Marcoss53/cenk-desktop-robot/3d-models/desk_robot_v1.3mf

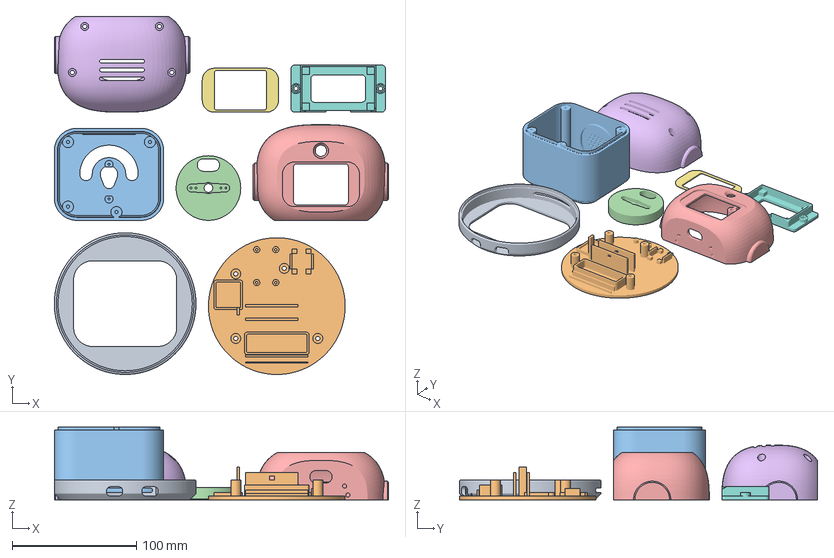
[picture p6: CAD file, 2026-10-13]
3d-models/desk_robot_v1.3mf
269.0 x 288.0 x 58.4 mm
pedestal
base_plate
body_shell
neck_hub
head_front
head_back
visor
display_bracket
