Marcoss53/cenk-desktop-robot/3d-models/stl/neck_hub.stl

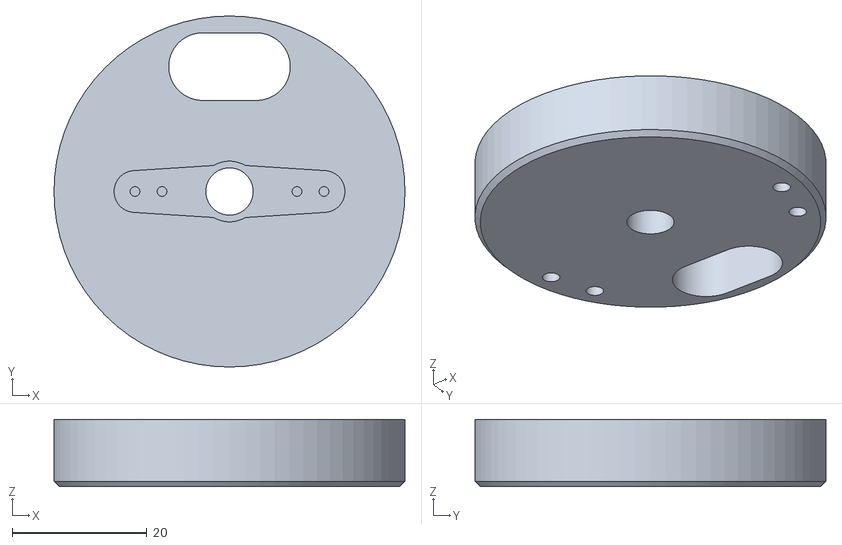
[picture p7: CAD file, 2026-10-13]
3d-models/stl/neck_hub.stl
52.0 x 52.0 x 10.0
