Marcoss53/cenk-desktop-robot/3d-models/stl/camera_bracket.stl

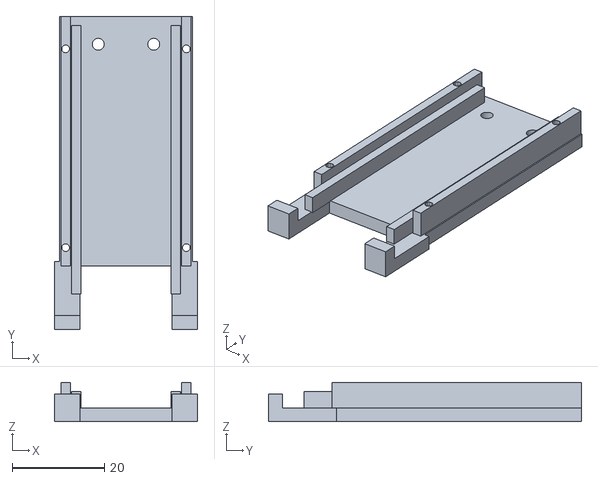
[picture p8: CAD file, 2026-10-13]
3d-models/stl/camera_bracket.stl
31.0 x 67.7 x 8.50
