Marcoss53/cenk-desktop-robot/3d-models/stl/body_shell.stl

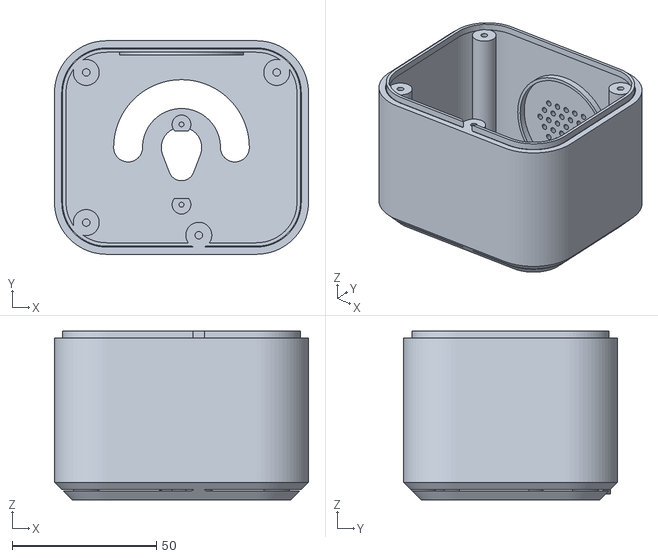
[picture p9: CAD file, 2026-10-13]
3d-models/stl/body_shell.stl
88.0 x 74.0 x 58.4
