Marcoss53/cenk-desktop-robot/3d-models/stl/pedestal.stl

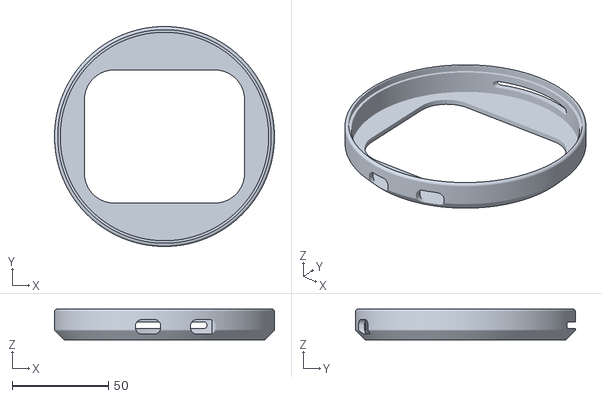
[picture p10: CAD file, 2026-10-13]
3d-models/stl/pedestal.stl
114.0 x 114.0 x 16.0
