Marcoss53/cenk-desktop-robot/3d-models/stl/head_back.stl

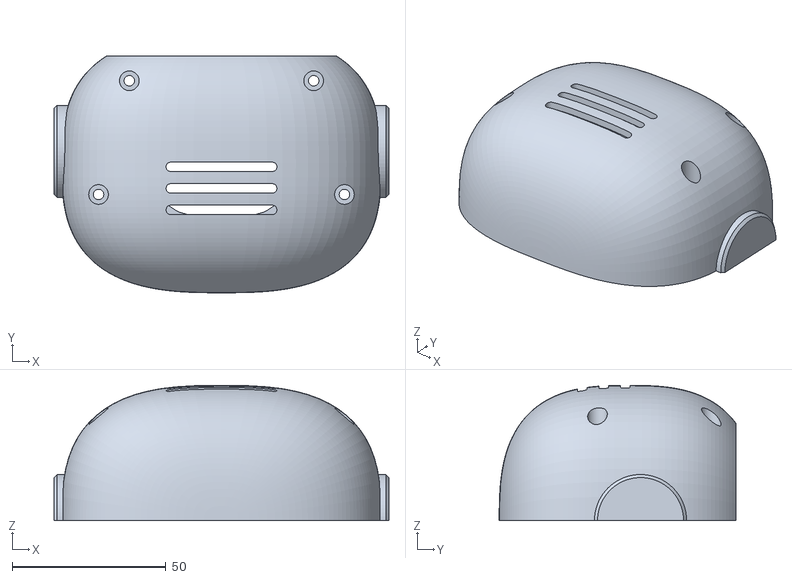
[picture p11: CAD file, 2026-10-13]
3d-models/stl/head_back.stl
109.0 x 77.0 x 44.0
