Marcoss53/cenk-desktop-robot/3d-models/stl/display_bracket.stl

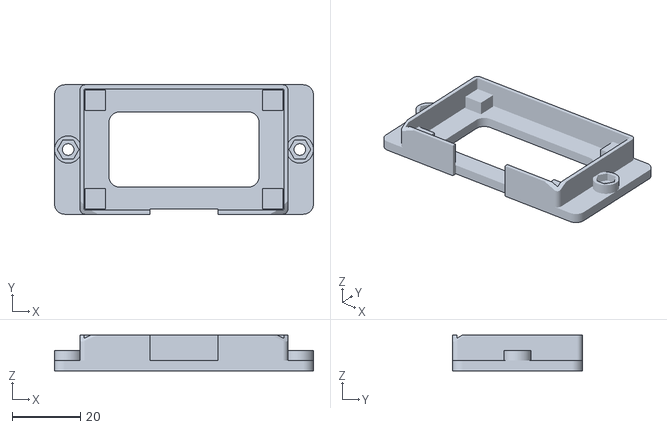
[picture p12: CAD file, 2026-10-13]
3d-models/stl/display_bracket.stl
76.0 x 38.0 x 10.5
