Marcoss53/cenk-desktop-robot/3d-models/stl/head_front.stl

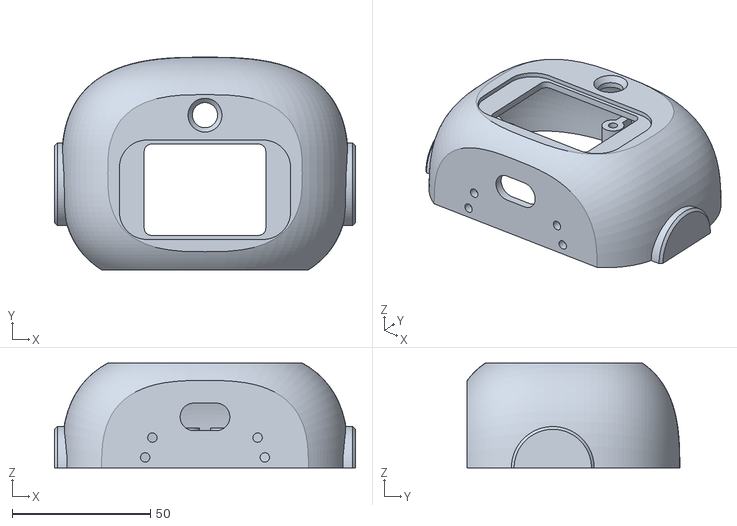
[picture p13: CAD file, 2026-10-13]
3d-models/stl/head_front.stl
109.0 x 77.0 x 38.0
