Marcoss53/cenk-desktop-robot/3d-models/stl/visor.stl

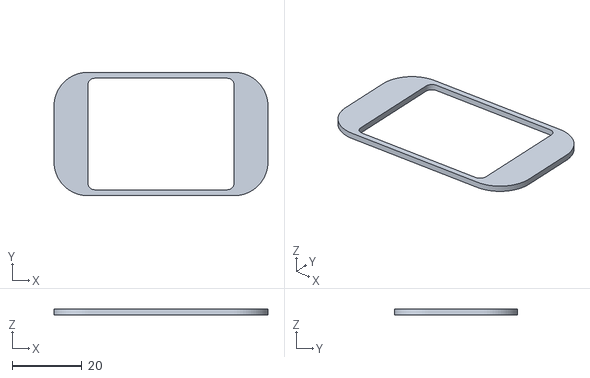
[picture p14: CAD file, 2026-10-13]
3d-models/stl/visor.stl
61.4 x 35.4 x 1.60
