Marcoss53/cenk-desktop-robot/3d-models/stl/base_plate.stl

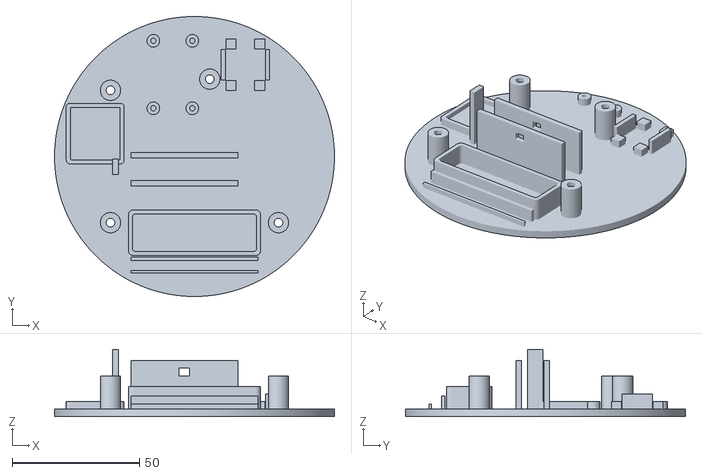
[picture p15: CAD file, 2026-10-13]
3d-models/stl/base_plate.stl
110.0 x 110.0 x 26.4
