Marcoss53/cenk-desktop-robot/firmware/robot_fw/merhaba_ses.h

#pragma once
const uint8_t MERHABA[] PROGMEM={128,127,127,127,126,126,126,125,125,125,125,125,125,125,125,126,126,126,126,126,126,127,127,128,128,129,129,129,129,129,129,129,128,128,128,128,129,129,130,130,131,131,131,131,130,129,129,129,129,129,129,131,133,134,135,137,138,138,138,137,137,137,137,136,137,137,138,140,142,143,142,141,141,139,137,134,132,131,130,128,126,128,129,130,127,126,125,124,121,117,116,115,114,113,113,115,116,118,119,119,119,119,119,119,118,117,117,118,119,121,122,124,126,127,127,127,127,127,126,125,124,124,125,125,126,126,127,128,128,128,128,128,127,127,127,127,127,127,128,128,129,129,130,130,130,131,131,131,131,131,131,131,131,131,131,131,130,130,130,129,129,129,128,128,127,127,127,126,126,126,126,125,125,125,125,125,125,125,125,125,125,125,126,126,127,127,128,128,129,129,129,129,129,128,128,128,128,128,128,129,130,131,132,132,133,132,131,130,129,130,129,129,130,132,134,136,138,140,142,142,141,139,139,138,138,137,137,138,140,142,145,146,146,145,144,142,138,134,131,130,129,126,125,128,130,131,128,126,125,124,119,115,113,111,110,109,110,112,115,117,118,119,118,118,117,116,115,113,113,114,116,118,120,123,126,127,127,126,126,126,125,123,122,123,123,124,125,126,128,128,129,129,129,129,128,128,127,127,127,127,128,129,129,130,131,131,131,131,131,131,131,131,131,130,130,130,130,130,130,129,129,129,128,128,128,127,127,127,126,126,126,126,126,126,126,125,125,125,125,125,125,125,125,126,127,127,128,129,129,129,129,128,128,127,126,126,127,127,128,130,131,133,134,134,135,133,132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
const uint32_t MERHABA_LEN=20004;
