Marcoss53/cenk-desktop-robot/(notices)

Notices in the files:
README.md:
License: MIT
